BrianVanCampen/Farmlab/PompController_brian/PompController_brian_3Dpcb.png

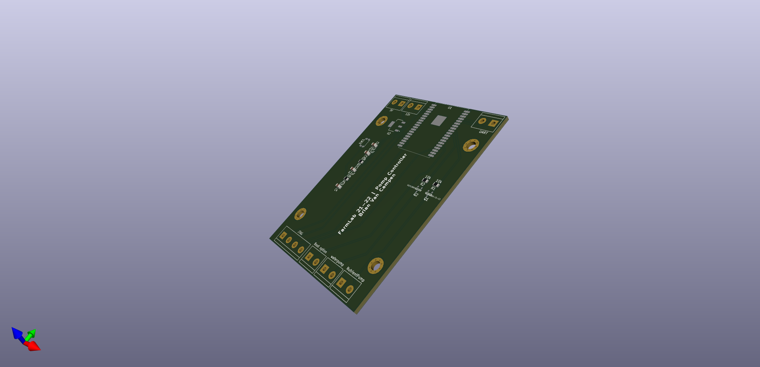
PompController_brian/PompController_brian_3Dpcb.png
