BrianVanCampen/Farmlab/Documentatie_PompController.md

# IOT project



Link naar PDF : [IOTProjects_Documentatie_pompcontroller_brian.pdf](https://github.com/BrianVanCampen/Farmlab/files/8911796/IOTProjects_Documentatie_pompcontroller_brian.pdf)

## beschrijving van het project

Dit project is de 5de iteratie van Farmlab, de bedoeling is om basilicum te groeien en alles er van te automatiseren. Hiervoor moeten aantal onderdelen ontworpen of verbeterd worden. Vervolgens worden er steeds nieuwe iteraties gemaakt met steeds deze verbeteringen.

## Wat is het doel van het project?

Als een team samenwerken aan deelprojecten om zo stap voor stap een volledig project kunnen te verwezenlijken.

Deze iteratie heeft ook als doel de 4de iteratie te fine tunen:

- Herwerken van PCBs
- XY-systeem
- automatisering
- Documentatie

# Pomp controller

### Beschrijving pompcontroller

De pompcontroller moet in staat zijn om het water op het gepaste moment rond te pompen. Hierdoor kunnen er geen algen of andere planten in het water groeien doordat het water te lang heeft stil gestaan. Dit proces moet automatisch gebeuren zodat de gebruiker niet om de zoveel tijd manueel de pomp moet aanzetten. Daarnaast is er nog een tweede pomp om de voedingsstoffen toe te voegen aan het water zodat de planten optimaal kunnen groeien. Ook deze wordt geautomatiseerd en remote aanpasbaar zodat de hoeveelheden voedingstoffen kunnen worden aangepast indien nodig. Tot nu toe werd er gewerkt met een pomp die manueel werd aangestuurd en zitten ze in het proces om te kijken of al de buizen waterdicht zijn. Basilicum heeft verschillende voedingsstoffen nodig om te kunnen groeien. Kalium en calcium zijn twee voedingswaarden waar basilicum voldoende van moet krijgen. Deze moeten op een 1:1 basis worden gegeven. Daarnaast spelen magnesium en stikstof nog een significante rol. Het magnesium gehalte zou 50 ppm moeten zijn. Aan de hand van de electric conductivity (EC) kan er worden gekeken of de basilicum genoeg voedingsstoffen kan opnemen. De EC is het zoutgehalte in het voedingswater en wordt uitgedrukt in μS/cm. De EC zou een waarde tussen 1.6 en 2.2 μS/cm moeten hebben. (Miller, 2020; Smith, 2021; Deepak, 2020; Sandy, 2021)

# Blokdiagram



# Elecktrisch Schema

### Microcontroller



### Microcontroller Peripherals



### Pomp Aansturing



### Spannings Regelaar 



### Voeding & Montage gaten



# PCB ontwerp

### Voorkant

KiCad: 





### Achterkant



### 3D ontwerp





# Componenten

|Pomp|Naam|Spanning|Stroom|Vermogen|Link|
|---|---|---|---|---|---|
||Barwig Typ 04 0444 Laagspanning dompelpomp 600 l/h 6 m|12V|1.7A|20W|<ul>https://www.conrad.be/nl/p/barwig-typ-04-0444-laagspanning-dompelpomp-600-l-h-6-m-539090.html</ul>|

|Component|Soort|Naam|Link|
|---|---|---|---|
||Microcontroller|ESP32-wrover|<ul> https://www.tinytronics.nl/shop/nl/communicatie-en-signalen/draadloos/wi-fi/modules/esp32-wrover-wifi-module-pcb-antenne-aansluiting </ul> <ul>https://www.tinytronics.nl/shop/index.php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</ul>|
||Power mosfet|SI2312BDS-T1-E3|<ul> https://be.farnell.com/vishay/si2312bds-t1-e3/mosfet-n-ch-20v-3-9a-sot-23-3/dp/2396085 </ul> <ul>https://www.farnell.com/datasheets/2045689.pdf</ul>|
||Spannings regelaar|AP7361-33E-13|<ul>https://be.farnell.com/diodes-inc/ap7361-33e-13/ldo-fixed-3-3v-1a-40-to-85deg/dp/3482976</ul>|

# Din Rail Enclosure

RS PRO Modular Enclosure Enclosure Type, 70.0 x 90.0 x 65.0mm, ABS DIN Rail Enclosure



**Gegevens:**

Category Enclosures Modular for DIN rail
Type Full
Material ABS V0
Variant Without gasket
Height 65.0 mm
Width 90.0 mm
Length 70.0 mm
Color Lightgray (J)
Standards Met RoHS Compliant
Accessories Black hook: 1.0 pcs
Certificate number CE/032/18 Dashed line shows outline of the mounting boss under PCB board

**Afmetingen**



Recommended mounting holes diameter ø3,5mm

**Links**

https://benl.rs-online.com/web/p/din-rail-enclosures/1862295

# Software Analyse

## Data

Data wordt grotendeels verstuurd tussen de centrale ESP32 (broker MQTT en Node-RED) en de ESP32's aanwezig op de PCB's.
Alle data die tussen deze 2 uitgestuurd worden zullen van het type String zijn.

**PompController:**

<ol>

  <ul>
    <li>Node-RED -> Centrale RaspberryPi -> ESP32 op pompcontroller:</li>
    <ul>
      <li>Topics: Pump/water OF Pump/nutrients</li>
      <li>String "on" => Pomp gaat aan</li>
      <li>String "off" => Pomp gaan uit</li>
    </ul>
</ol>

| HTTP |MQTT |
| --- | --- |
| Vrij zwaar protocol: de header van een package is al groter dan 1 bericht van MQTT
(min +- 26 bytes header vs enkele bytes MQTT message) | Weinig data → meer keuzes op fysieke laag, trage links worden mogelijk |
| Software stack / Software stack / Library Library is vrij zwaar heeft een zeer kleine footprint | Lightweight → protocol last ook in kleine devices, sensors.. met weinig geheugen & cpu power. |
| Geen ingebouwde Standaard enkele QoS mogelijkheden| Standardisatie, compatibilieit → elk device kan hetzelfde protocol gebruiken → MQTT bouwt verder op de TCP/IP stack|
| | Vereenvoudiging → bij complexe configuraties (zie principe MQTT) |

=>MQTT omdat dit protocol gemaakt is om kleinere bytes aan data door te sturen en dit makkelijk te implementeren is in de opstelling.

### IOT Dashboard/Platform

**Er is een platform/server nodig om:**

- Verzamelde data weer te geven
- Controle opdrachten te sturen
- Automatisatie programma's te beheren

|Node-RED|Thingsboard|Freeboard.io|
| --- | --- | --- |
| Open-source | Open-source+ professional(betalend) | Open-source |
| Flows | Entities |  |
| no API | API |  |
| Supports MQTT out of the box | Supports MQTT out of the box | Does not support MQTT out of the box (Not actively developed Plugin available) |
| Makkelijk om snel data te kunnen verwerken naar een dashboard aan de hand van flows | Eerder gemaakt voor professionele klanten, werkt met verschillende entities voor apparaten en klanten. |  |

=>Node-RED gebruiken omdat dit ingebouwde MQTT support heeft (Wat Freeboard.io niet heeft) en omdat dit op maat is van het project (Thingsboard zou te uitgebreid zijn).

(De Gendt et al., 2021)

## Beschrijving van de mogelijke interfaces

Deze kast maakt gebruik van Node-RED die gaat communniceren met een centrale RaspberryPi. Hieruit worden de verschillende controller/sensor ESP32’s aangestuurd.



## Handleiding Web Interactie

Dit is de handleiding om te starten met Node-RED:

1. je surft naar https://nodered.org/
2. je scrollt tot aan Get Started 

3. volg deze stappen: https://nodered.org/docs/getting-started/local
4. Je typt in de console

       $ node-red

6. je gaat naar deze link

6. Hier kan je de Flow van het project aanmaken

7. Voor de pomp controller kan je het bestand importeren boven aan rechts of CTRL+I 

8. zorg er ook voor dat je in Node-RED de plugin Node-red-dashboard installeert door bovenaan rechts manage pallete te kiezen 
9. vervolgens zoek je Node-red-dashboard in de install tab


10. klik op dashboard bovenaan rechts


11. hier kan je van alles aanpassen
12. Om de UI te openen klik je op het vierkantje bovenaan rechts



### zip van flow
[flows.zip](https://github.com/BrianVanCampen/Farmlab/files/8910688/flows.zip)

### Arduino code

[PompController Arduino Code.zip](https://github.com/BrianVanCampen/Farmlab/files/8911117/PompController.Arduino.Code.zip)

# Tijdelijke Problemen



## Testen van PCB

### SpanningsRegelaar

Foute footprint bij spanningsregelaar 5V output in plaats van 3V3 (zie foto)


Max waarde ESP32: 



De ESP32 kan maar 3.9V max aan 

### Power MOSFET

Geen gepaste MOSFET gebruikt(Through-hole vs SMD) ,IRF9530N inplaats van SI2312BDS-T1-E3





## Mogelijke uitbreidingen 

- Verkleinen van pcb
- Sensoren toevoegen
