BrianVanCampen/Farmlab/PompController_brian/PompController_brian.kicad_pcb

## KiCad design PompController_brian/PompController_brian.kicad_pcb (2022-06-14)

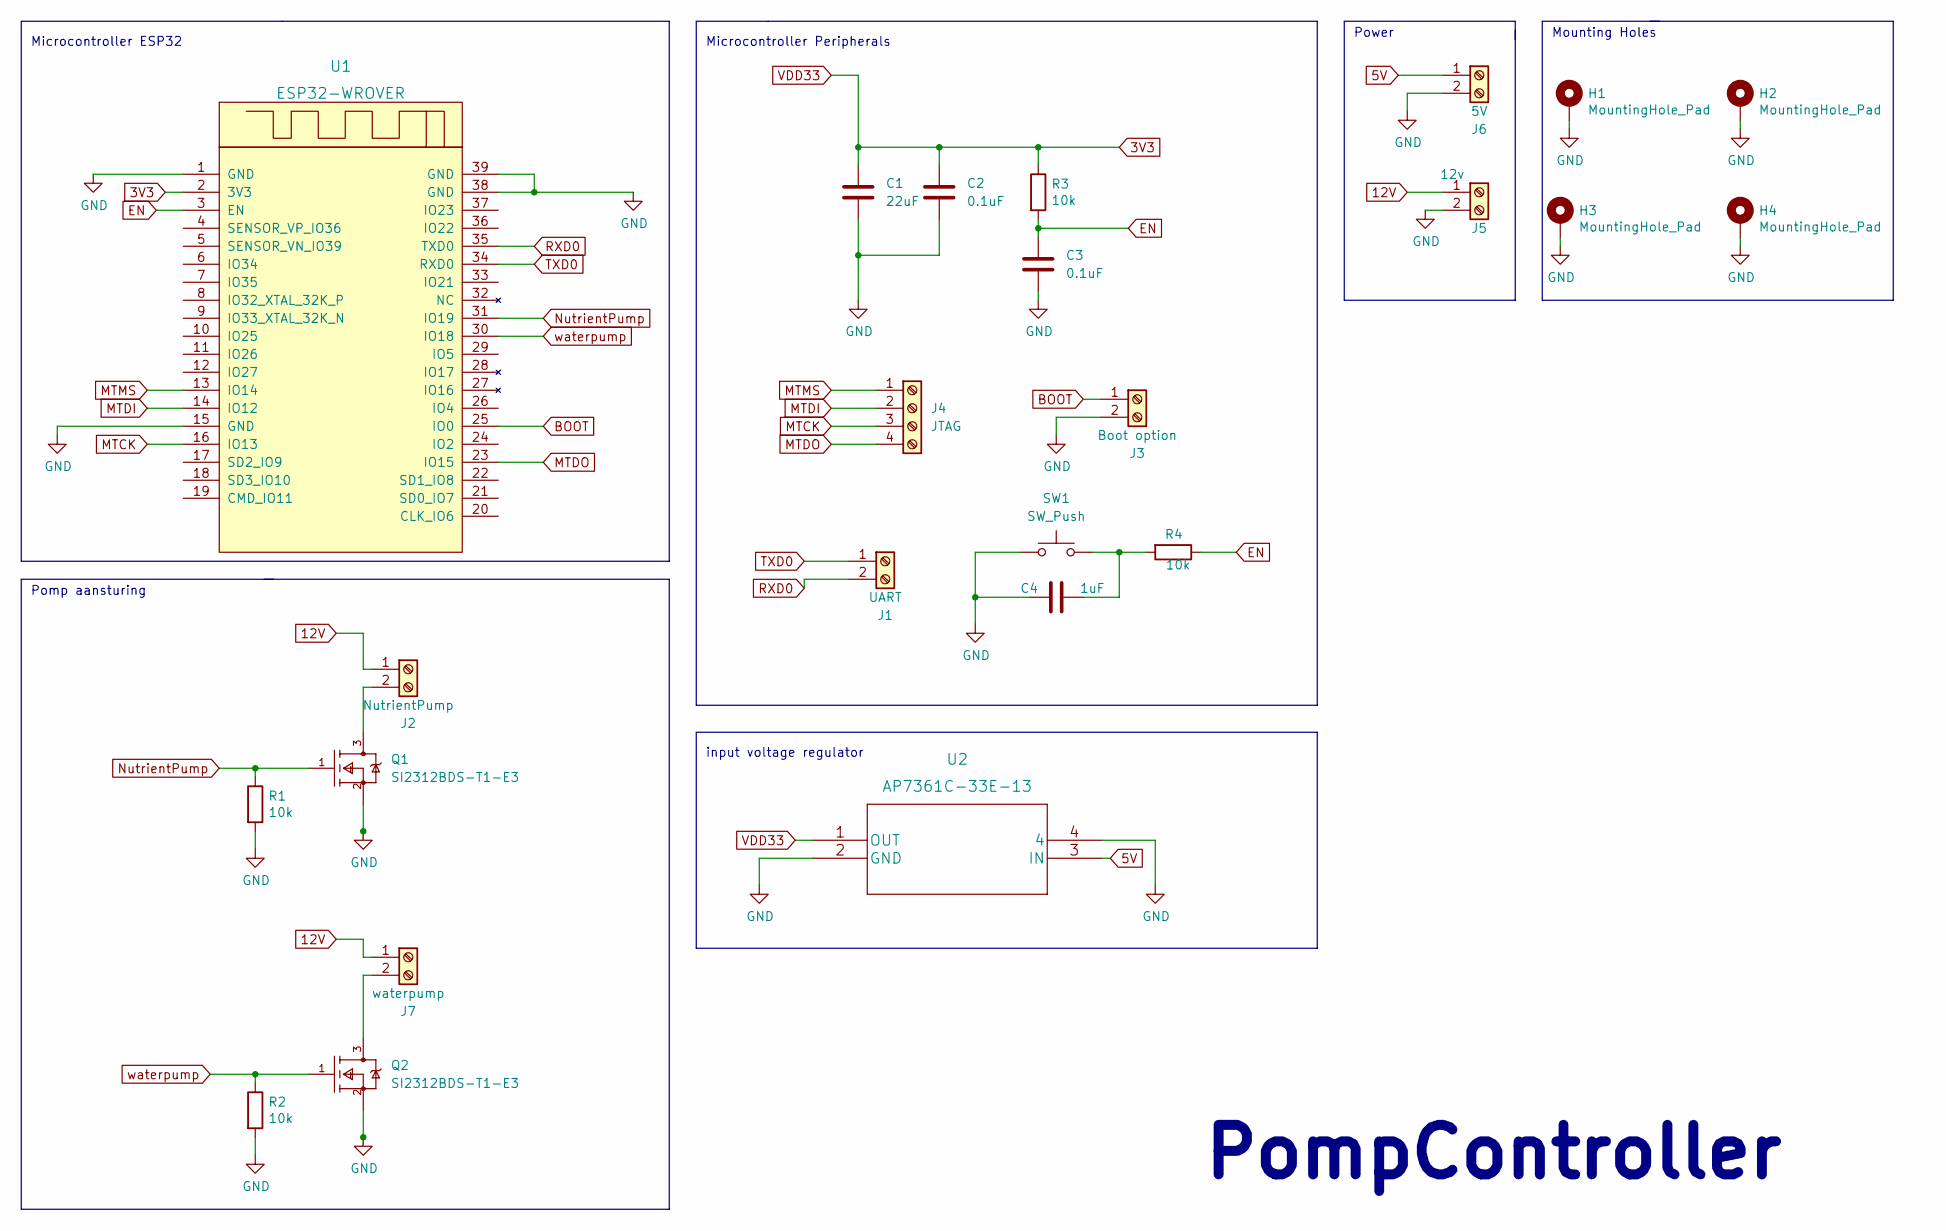
[picture p2: schematic PompController_brian.kicad_sch]

Parts:
C1: 22uF; C_0805_2012Metric
C2, C3: 0.1uF; C_0805_2012Metric
C4: 1uF; C_0805_2012Metric
H1, H2, H3, H4: MountingHole_Pad; MountingHole_3mm_Pad_Via
J1: UART; TerminalBlock_bornier-2_P5.08mm
J2: NutrientPump; TerminalBlock_bornier-2_P5.08mm
J3: Boot option; TerminalBlock_bornier-2_P5.08mm
J4: JTAG; TerminalBlock_bornier-4_P5.08mm
J5: 12v; TerminalBlock_bornier-2_P5.08mm
J6: 5V; TerminalBlock_bornier-2_P5.08mm
J7: waterpump; TerminalBlock_bornier-2_P5.08mm
Q1, Q2: SI2312BDS-T1-E3; Vishay-SI2312BDS-T1-E3-0; mouser part number 781-SI2312BDS-E3; digikey description MOSFET N-CH 20V 3.9A SOT23-3
R1, R2, R3, R4: 10k; R_0805_2012Metric
SW1: SW_Push; SW_Push_1P1T_NO_CK_KMR2
U1: ESP32-WROVER
U2: AP7361C-33E-13; SOT230P700X180-4N

Connections:
3V3: C1.2, C2.1, R3.1, U1.2 (3V3), U2.1 (OUT)
5V: J6.1, U2.3 (IN)
12V: J2.1, J5.1, J7.1
BOOT: J3.1, U1.25 (IO0)
EN: C3.1, R3.2, R4.1, U1.3 (EN)
GND: C1.1, C2.2, C3.2, C4.1, H1.1, H2.1, H3.1, H4.1, J3.2, J5.2, J6.2, Q1.2 (S), Q2.2 (S), R1.2, R2.2, SW1.1, U1.1 (GND), U1.15 (GND), U1.38 (GND), U1.39 (GND), U2.2 (GND), U2.4
MTCK: J4.3, U1.16 (IO13)
MTDI: J4.2, U1.14 (IO12)
MTDO: J4.4, U1.23 (IO15)
MTMS: J4.1, U1.13 (IO14)
unnamed: C4.2, R4.2, SW1.2
unnamed: J2.2, Q1.3 (D)
unnamed: J7.2, Q2.3 (D)
NutrientPump: Q1.1 (G), R1.1, U1.31 (IO19)
RXD0: J1.2, U1.35 (TXD0)
TXD0: J1.1, U1.34 (RXD0)
waterpump: Q2.1 (G), R2.1, U1.30 (IO18)

Notes on the sheet:
PompController
Microcontroller Peripherals
Microcontroller ESP32
Mounting Holes
Pomp aansturing
Power
input voltage regulator

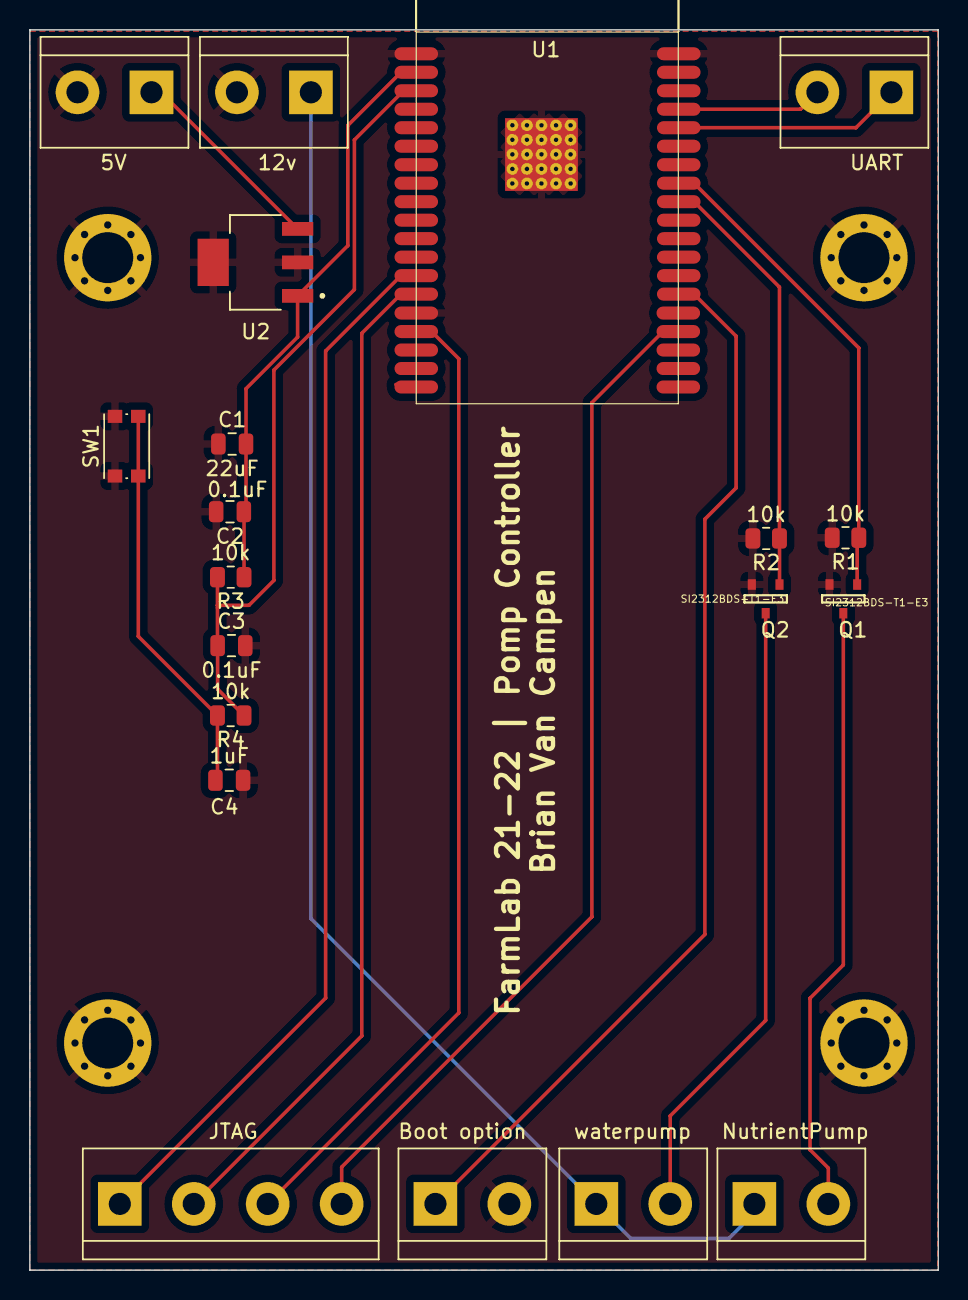
[picture p3: board PompController_brian.kicad_pcb from above]

Board: 2 copper layers, 62.4 x 85.2 mm, 24 parts (0 on the bottom side), 17 nets.
