BrianVanCampen/Farmlab/PompController Arduino Code/farmlabcontroller.ino

#include <PubSubClient.h>
#include <WiFi.h>





#define Pomp1            18
#define Pomp2            19

// Update these with values suitable for your network.

const char* ssid = "brian";
const char* password = "12345678";
const char* mqtt_server = "mqtt.luytsm.be"; 

const char* username = "";
const char* pass = "";


// Subscribed Topics

#define sub1 "Pump/water"
#define sub2 "Pump/nutrient"

WiFiClient espClient;
PubSubClient client(espClient);
unsigned long lastMsg = 0;
#define MSG_BUFFER_SIZE  (50)
char msg[MSG_BUFFER_SIZE];
int value = 0;


// Connecting to WiFi Router

void setup_wifi()
{

  delay(10);
  // We start by connecting to a WiFi network
  Serial.println();
  Serial.print("Connecting to ");
  Serial.println(ssid);

  
  WiFi.begin(ssid, password);

  while (WiFi.status() != WL_CONNECTED) {
    delay(500);
    Serial.print(".");
  }

  randomSeed(micros());

  Serial.println("");
  Serial.println("WiFi connected");
  Serial.println("IP address: ");
  Serial.println(WiFi.localIP());
}

void callback(char* topic, byte* payload, unsigned int length)
{
  Serial.print("Message arrived [");
  Serial.print(topic);
  Serial.print("] ");


  if (strstr(topic, sub1))
  {
    for (int i = 0; i < length; i++)
    {
      Serial.print((char)payload[i]);
    }
    Serial.println();
   
    if ((char)payload[0] == '1')
    {
      digitalWrite(Pomp1, HIGH);   
    } else {
      digitalWrite(Pomp1, LOW); 
    }
  }

  else if ( strstr(topic, sub2))
  {
    for (int i = 0; i < length; i++) {
      Serial.print((char)payload[i]);
    }
    Serial.println();
    
    if ((char)payload[0] == '1') {
      digitalWrite(Pomp2, HIGH);   
    } else {
      digitalWrite(Pomp2, LOW); 
    }
  }

  else
  {
    Serial.println("unsubscribed topic");
  }

}


// Connecting to MQTT broker

void reconnect()
{
  // Loop until we're reconnected
  while (!client.connected()) {
    Serial.print("Attempting MQTT connection...");
    // Create a random client ID
    String clientId = "ESP8266Client-";
    clientId += String(random(0xffff), HEX);
    // Attempt to connect
    if (client.connect(clientId.c_str() , username, pass)) {
      Serial.println("connected");
      // Once connected, publish an announcement...
      client.publish("outTopic", "hello world");
      // ... and resubscribe
      client.subscribe(sub1);
      client.subscribe(sub2);
    } else {
      Serial.print("failed, rc=");
      Serial.print(client.state());
      Serial.println(" try again in 5 seconds");
      // Wait 5 seconds before retrying
      delay(5000);
    }
  }
}



void setup()
{

  pinMode(Pomp1, OUTPUT);
  pinMode(Pomp2, OUTPUT);


  Serial.begin(115200);

  setup_wifi();

  client.setServer(mqtt_server, 1883);
  client.setCallback(callback);
}

void loop()
{

  if (!client.connected()) 
  {
    reconnect();
  }
  client.loop();

}
